IoT-Internship-CarAutomation-LUS/Car-Automation/hardware/README.md

# Hardware / Procurement

**Owner: Venkat**

Platform build, parts research, wiring diagrams, and build photos.

- `wiring/` — connection diagrams and pin maps.
- `photos/` — build progress photos.
- Parts list lives in `../docs/parts-list.md`.

Phase 1 = cheap servo proof-of-concept car with the two-node CAN bus. **No buying until budget sign-off.**
