IoT-Internship-CarAutomation-LUS/Car-Automation/docs/day-reports/README.md

# Daily Reports

Day-by-day planning and progress documents (Word/PDF versions are shared with the team lead; key ones summarised here).

- Day 1 — Board 1 hardware documentation
- Day 2 — Board 2 GPS + CAN bring-up (GPS working, CAN loopback passing)
- Day 3 — ELM327 + TPMS research, 32/16-byte payload design
- Day 4 — System design & integration plan (two dashboards, architecture, tracks)
- Day 5 — Cloud streaming + in-house ELM327 direction (in progress)
