IoT-Internship-CarAutomation-LUS/Car-Automation/docs/day-reports/2026-07-31.md

# Day Report — 2026-07-31

This file has two parts. The **Automated Activity Log** is generated from git — it never needs to be typed by hand, and re-running the digest just refreshes it without touching anything below. The **Team Notes** and **Day Summary** are manual — git can't know what worked, what didn't, or what the output looked like. That part only a person can write.

## Automated Activity Log
<!-- AUTO:START -->
**5 commit(s) on 2026-07-31**

### `(root)/`
- `17:09` **ShahidMihransha** — docs: refresh README for real-vehicle-only track and schema v2.0.0 (`1bfdc2c`)
- `20:54` **ShaahirAhamed** — added (`ccc50ee`)

### `Internship/`
- `17:09` **ShahidMihransha** — Add Accelerator Actuation, Data Collection, and Final Internship Report docs (`63e585f`)

### `backend/`
- `17:09` **ShahidMihransha** — Add Accelerator Actuation, Data Collection, and Final Internship Report docs (`63e585f`)
- `17:09` **ShahidMihransha** — Simplify elm327_bt.py TCP forwarding and drop redundant gear estimation (`f857870`)
- `17:09` **ShahidMihransha** — docs: refresh README for real-vehicle-only track and schema v2.0.0 (`1bfdc2c`)
- `20:42` **ShaahirAhamed** — changed something small (`4f6ab03`)
- `20:54` **ShaahirAhamed** — added (`ccc50ee`)

<!-- AUTO:END -->

## Team Notes (fill in manually)

Everyone who did meaningful work today adds a short block below. Copy the template for each person/track. Keep it brief — a few lines each is enough.

### [Name — Track]
- **What was done:**
- **What worked:**
- **What didn't work / issues:**
- **Output / result:**
- **Next steps:**

<!-- copy the block above for each additional person -->

## Day Summary (team lead)

- **Overall progress:**
- **Blockers:**
- **Decisions made today:**
