IoT-Internship-CarAutomation-LUS/Car-Automation/docs/day-reports/2026-07-18.md

# Day Report — 2026-07-18

This file has two parts. The **Automated Activity Log** is generated from git — it never needs to be typed by hand, and re-running the digest just refreshes it without touching anything below. The **Team Notes** and **Day Summary** are manual — git can't know what worked, what didn't, or what the output looked like. That part only a person can write.

## Automated Activity Log
<!-- AUTO:START -->
**8 commit(s) on 2026-07-18**

### `(root)/`
- `01:10` **ShahidMihransha** — Add tracked pre-commit hook to block unresolved merge conflict markers (`40b3c95`)

### `Internship/`
- `14:51` **ShaahirAhamed** — changed the folder of the Day4 Document (`381ea79`)

### `backend/`
- `01:32` **ShahidMihransha** — Resolve unresolved merge conflict markers from 89e4c6b (`ce5e733`)
- `01:39` **ShahidMihransha** — Add --tcp mode for direct Pi-to-laptop packet streaming (`2351c3f`)
- `02:14` **ShahidMihransha** — Add raw_receiver.py and decoded_receiver.py for --tcp bench-test link (`2eeee9b`)

### `dashboard-telemetry/`
- `15:15` **ShaahirAhamed** — modifified the front end code to work with the updated backend (`075eef4`)

### `firmware/`
- `19:15` **ShaahirAhamed** — Added a new sketch for Reverse Engineering CAN using esp32 (`5ad7f15`)

### `scripts/`
- `01:10` **ShahidMihransha** — Add tracked pre-commit hook to block unresolved merge conflict markers (`40b3c95`)
- `17:17` **ShaahirAhamed** — Added a Can_sniffer to reverse engineer manufacure raw hex (`67a1dd0`)

<!-- AUTO:END -->

## Team Notes (fill in manually)

Everyone who did meaningful work today adds a short block below. Copy the template for each person/track. Keep it brief — a few lines each is enough.

### [Name — Track]
- **What was done:**
- **What worked:**
- **What didn't work / issues:**
- **Output / result:**
- **Next steps:**

<!-- copy the block above for each additional person -->

## Day Summary (team lead)

- **Overall progress:**
- **Blockers:**
- **Decisions made today:**
