IoT-Internship-CarAutomation-LUS/Car-Automation/docs/day-reports/2026-07-15.md

# Day Report — 2026-07-15

This file has two parts. The **Automated Activity Log** is generated from git — it never needs to be typed by hand, and re-running the digest just refreshes it without touching anything below. The **Team Notes** and **Day Summary** are manual — git can't know what worked, what didn't, or what the output looked like. That part only a person can write.

## Automated Activity Log
<!-- AUTO:START -->
**3 commit(s) on 2026-07-15**

### `(root)/`
- `08:44` **ShaahirAhamed** — added a logs folder for dumping backend and frontend logs (`5d9c6c3`)
- `13:50` **ShahidMihransha** — cleanup (`b2992a4`)

### `Internship/`
- `13:54` **ShahidMihransha** — docs: add Three Day Progress Report (docx + pdf) (`7ad4e63`)

### `backend/`
- `13:50` **ShahidMihransha** — cleanup (`b2992a4`)

### `dashboard-control/`
- `13:50` **ShahidMihransha** — cleanup (`b2992a4`)

### `dashboard-telemetry/`
- `13:50` **ShahidMihransha** — cleanup (`b2992a4`)

### `docs/`
- `13:50` **ShahidMihransha** — cleanup (`b2992a4`)

<!-- AUTO:END -->

## Team Notes (fill in manually)

Everyone who did meaningful work today adds a short block below. Copy the template for each person/track. Keep it brief — a few lines each is enough.

### [Name — Track]
- **What was done:**
- **What worked:**
- **What didn't work / issues:**
- **Output / result:**
- **Next steps:**

<!-- copy the block above for each additional person -->

## Day Summary (team lead)

- **Overall progress:**
- **Blockers:**
- **Decisions made today:**
