IoT-Internship-CarAutomation-LUS/Car-Automation/docs/day-reports/2026-07-14.md

# Day Report — 2026-07-14

This file has two parts. The **Automated Activity Log** is generated from git — it never needs to be typed by hand, and re-running the digest just refreshes it without touching anything below. The **Team Notes** and **Day Summary** are manual — git can't know what worked, what didn't, or what the output looked like. That part only a person can write.

## Automated Activity Log
<!-- AUTO:START -->
**3 commit(s) on 2026-07-14**

### `(root)/`
- `16:43` **ShahidMihransha** — Land OBD/ELM327 acquisition pipeline + schema versioning (`78e28c0`)

### `Instruction Docs/`
- `16:43` **ShahidMihransha** — Land OBD/ELM327 acquisition pipeline + schema versioning (`78e28c0`)

### `Internship/`
- `16:43` **ShahidMihransha** — Land OBD/ELM327 acquisition pipeline + schema versioning (`78e28c0`)
- `16:57` **ShahidMihransha** — docs (`d92741a`)

### `backend/`
- `16:43` **ShahidMihransha** — Land OBD/ELM327 acquisition pipeline + schema versioning (`78e28c0`)

### `dashboard-telemetry/`
- `16:43` **ShahidMihransha** — Land OBD/ELM327 acquisition pipeline + schema versioning (`78e28c0`)

### `docs/`
- `16:43` **ShahidMihransha** — Land OBD/ELM327 acquisition pipeline + schema versioning (`78e28c0`)
- `16:45` **daily-digest-bot** — docs: update daily activity digest [automated] (`7826f3b`)

### Pull requests merged
- #7 Land Schema_Versioning: OBD/ELM327 pipeline + schema versioning (history-scrubbed) — @ShahidMihransha

<!-- AUTO:END -->

## Team Notes (fill in manually)

Everyone who did meaningful work today adds a short block below. Copy the template for each person/track. Keep it brief — a few lines each is enough.

### [Name — Track]
- **What was done:**
- **What worked:**
- **What didn't work / issues:**
- **Output / result:**
- **Next steps:**

<!-- copy the block above for each additional person -->

## Day Summary (team lead)

- **Overall progress:**
- **Blockers:**
- **Decisions made today:**
