IoT-Internship-CarAutomation-LUS/Car-Automation/docs/day-reports/2026-07-06.md

# Day Report — 2026-07-06

## Automated Activity Log
<!-- AUTO:START -->
**11 commit(s) on 2026-07-06**

### `(root)/`
- `13:15` **Shaahir** — changed mock_telemetry.py (`1f4dce7`)
- `14:12` **ShahidMihransha** — docs: reconcile URLs, backend status, and schema drift; consolidate specs into docs/ (`4a465f7`)
- `15:54` **Shaahir** — Fixed an error in deployment that caused the css file to not load properly. (`ced2e95`)
- `16:00` **Shaahir** — deleted a unnecessary file, timetable.html (`4a7146b`)
- `16:02` **Shaahir** —  Modified .gitignore to include timetable.html,  ensuring it is ignored by Git. (`0fc4095`)
- `16:29` **ShahidMihransha** — chore: repo hygiene - gitignore, untrack db files, remove stray file, scrub name (`cc6f6b1`)
- `16:32` **ShahidMihransha** — docs: rescue ONBOARDING.md, day-report template, and Day5 docs from stale branch (`938bf81`)

### `Internship/`
- `16:32` **ShahidMihransha** — docs: rescue ONBOARDING.md, day-report template, and Day5 docs from stale branch (`938bf81`)

### `backend/`
- `13:15` **Shaahir** — changed mock_telemetry.py (`1f4dce7`)
- `14:12` **ShahidMihransha** — docs: reconcile URLs, backend status, and schema drift; consolidate specs into docs/ (`4a465f7`)

### `dashboard-control/`
- `14:12` **ShahidMihransha** — docs: reconcile URLs, backend status, and schema drift; consolidate specs into docs/ (`4a465f7`)
- `15:54` **Shaahir** — Fixed an error in deployment that caused the css file to not load properly. (`ced2e95`)

### `dashboard-telemetry/`
- `11:34` **Sapthagiri** — added changed Team leader assigned (`0ed2533`)
- `14:12` **ShahidMihransha** — docs: reconcile URLs, backend status, and schema drift; consolidate specs into docs/ (`4a465f7`)
- `14:58` **Sapthagiri** — made a change to display brake percentage (`a0e8eaa`)
- `15:54` **Shaahir** — Fixed an error in deployment that caused the css file to not load properly. (`ced2e95`)

### `docs/`
- `14:12` **ShahidMihransha** — docs: reconcile URLs, backend status, and schema drift; consolidate specs into docs/ (`4a465f7`)
- `14:51` **daily-digest-bot** — docs: update daily activity digest [automated] (`9a70024`)
- `15:27` **ShahidMihransha** — docs: mark backend brief as built/deployed and parts-list Phase 1 as superseded (`a019238`)
- `16:32` **ShahidMihransha** — docs: rescue ONBOARDING.md, day-report template, and Day5 docs from stale branch (`938bf81`)

### Pull requests merged
- #5 docs: reconcile URLs, backend status, schema drift; consolidate specs into docs/ — @ShahidMihransha

<!-- AUTO:END -->

## Team Notes (fill in manually)

## Day Summary
