IoT-Internship-CarAutomation-LUS/Car-Automation/docs/day-reports/2026-07-03.md

# Day Report — 2026-07-03

## Automated Activity Log
<!-- AUTO:START -->
**7 commit(s) on 2026-07-03**

### `(root)/`
- `15:55` **ShahidMihransha** — Initial repo structure, docs, dashboards, firmware (`e30d138`)

### `.github/`
- `17:06` **ShahidMihransha** — fix: daily digest committer-date bug, error handling, backfill input (`f44ce5b`)
- `17:44` **ShahidMihransha** — fix: use committer date for digest grouping, add error handling, PAT-based push, and backfill dispatch input (`10b50ef`)

### `Internship/`
- `15:55` **ShahidMihransha** — Initial repo structure, docs, dashboards, firmware (`e30d138`)

### `backend/`
- `15:55` **ShahidMihransha** — Initial repo structure, docs, dashboards, firmware (`e30d138`)

### `dashboard-control/`
- `15:55` **ShahidMihransha** — Initial repo structure, docs, dashboards, firmware (`e30d138`)
- `16:44` **Shaahir** — Sathish Added History (`9bed36a`)

### `dashboard-telemetry/`
- `15:55` **ShahidMihransha** — Initial repo structure, docs, dashboards, firmware (`e30d138`)
- `16:27` **Shaahir** — added the history page (`f8c136e`)

### `docs/`
- `15:55` **ShahidMihransha** — Initial repo structure, docs, dashboards, firmware (`e30d138`)
- `17:49` **daily-digest-bot** — docs: update daily activity digest [automated] (`cb21a8a`)
- `17:50` **daily-digest-bot** — docs: update daily activity digest [automated] (`3b6238b`)

### `firmware/`
- `15:55` **ShahidMihransha** — Initial repo structure, docs, dashboards, firmware (`e30d138`)

### `hardware/`
- `15:55` **ShahidMihransha** — Initial repo structure, docs, dashboards, firmware (`e30d138`)

### `scripts/`
- `17:06` **ShahidMihransha** — fix: daily digest committer-date bug, error handling, backfill input (`f44ce5b`)
- `17:44` **ShahidMihransha** — fix: use committer date for digest grouping, add error handling, PAT-based push, and backfill dispatch input (`10b50ef`)

### `sensing/`
- `15:55` **ShahidMihransha** — Initial repo structure, docs, dashboards, firmware (`e30d138`)

### Pull requests merged
- #2 fix: use committer date for digest grouping, add error handling, PAT-… — @ShahidMihransha
- #1 fix: daily digest committer-date bug, error handling, backfill input — @ShahidMihransha

<!-- AUTO:END -->

## Team Notes (fill in manually)

## Day Summary
