IoT-Internship-CarAutomation-LUS/Car-Automation/docs/day-reports/2026-07-04.md

# Day Report — 2026-07-04

## Automated Activity Log
<!-- AUTO:START -->
No commits recorded for this date.

<!-- AUTO:END -->

## Team Notes (fill in manually)

## Day Summary
