IoT-Internship-CarAutomation-LUS/Car-Automation/Internship/PDF/IoT_Internship_Board2_GPS_CAN_Bringup_Report (1).pdf

# ESP32 Vehicle Tracking System

## Board 2 Bring-up - Daily Work Report

IoT Development Team - Car Automation Internship

## 1. Aim of Today's Work

The aim of today's session was to bring up the second ESP32 prototype board and test two of its main modules individually: the GPS module (for live location) and the MCP2515 CAN module (for reading vehicle parameters). The goal was to prove that each module is correctly wired and working before combining everything into the final telemetry system.

Board 2 contains three modules in total: the NEO-6M GPS, the SIM800L GSM module, and the MCP2515 CAN controller. Today we successfully tested the GPS and the CAN module. The SIM800L was started but is left for the next session.

## 2. Components Used

- ESP32 development board
- GY-GPS6MV2 module (u-blox NEO-6M) with ceramic patch antenna
- MCP2515 CAN module (with TJA1050 transceiver, 8 MHz crystal)
- SIM800L EVB module (started but not completed today)
- Jumper wires and USB data cable
- Arduino IDE with TinyGPSPlus and mcp_can (coryjfowler) libraries

## 3. Wiring / Connection Details

### 3.1 GPS Module (NEO-6M) to ESP32

The GPS communicates with the ESP32 using a serial (UART) connection. The TX and RX lines are crossed (GPS TX goes to ESP32 RX, and GPS RX goes to ESP32 TX).

GPS Pin | ESP32 Pin | Purpose
VCC | 3V3 | Power (3.3V)
GND | GND | Ground
TX | D5 | GPS sends data to ESP32
RX | D4 | ESP32 sends data to GPS

### 3.2 MCP2515 CAN Module to ESP32

The CAN module communicates using the SPI bus. We used the ESP32's default VSPI pins for SCK, MISO and MOSI, plus a chip-select (CS) pin and an interrupt (INT) pin.

CAN Pin | ESP32 Pin | Purpose
VCC | 5V / VIN | Power (5V)
GND | GND | Ground
SCK | D18 | SPI clock
SO (MISO) | D19 | Data from CAN to ESP32
SI (MOSI) | D23 | Data from ESP32 to CAN
CS | D32 | Chip select
INT | D33 | Interrupt (new message ready)

### 3.3 Power Summary

Connection | Supply
GPS VCC | 3.3V
CAN VCC | 5V / VIN
All GND | Common ground

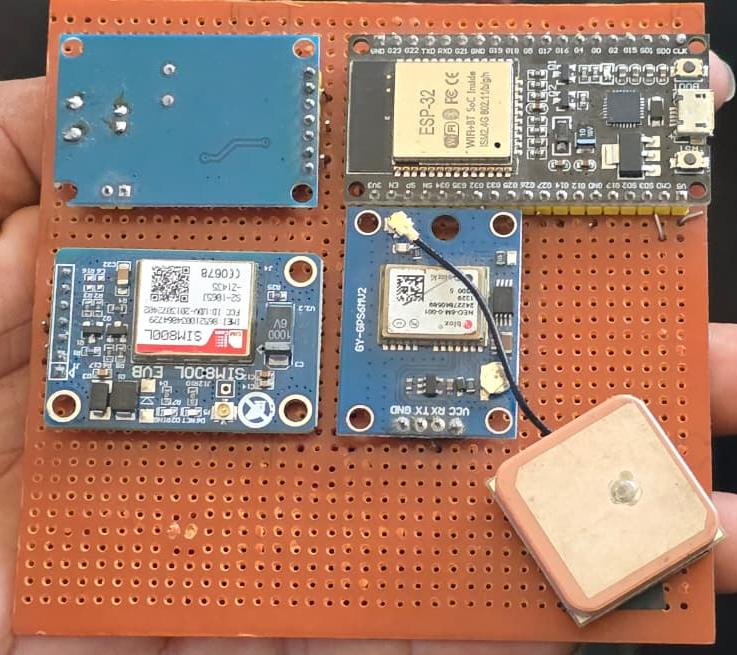
[picture p40: figure]
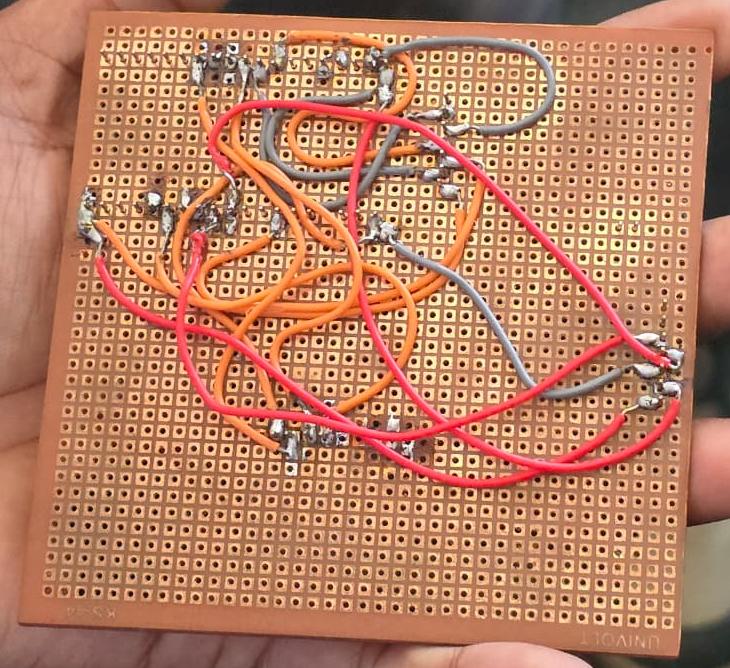
[picture p41: figure]

## 4. Work Done

A single Arduino test program was written to start all three modules together. The GPS is read on UART1, the SIM800L on UART2, and the CAN module on the SPI bus. The program prints a status line every 2 seconds so we can see what each module is doing on the Serial Monitor (baud 115200).

The two modules were tested one at a time:

1. First the GPS was taken to an open area to get a position fix.
2. Then the CAN module was tested using a loopback self-test (no vehicle needed).

## 5. Outputs Obtained

### 5.1 GPS Output (Live Location)

After being given a clear view of the sky, the GPS locked on to satellites and gave a valid position fix. A sample output line from the Serial Monitor:

[GPS] FIX lat 12.920364 lng 80.131663 sats 7 alt 19.9m spd 1.2 km/h 10:54:17 UTC
The position (12.9203 N, 80.1316 E) matched our actual location in Chennai. The number of satellites used reached 6-7, and the accuracy value (HDOP) came down to about 1.7-1.8, which is a good and reliable fix.

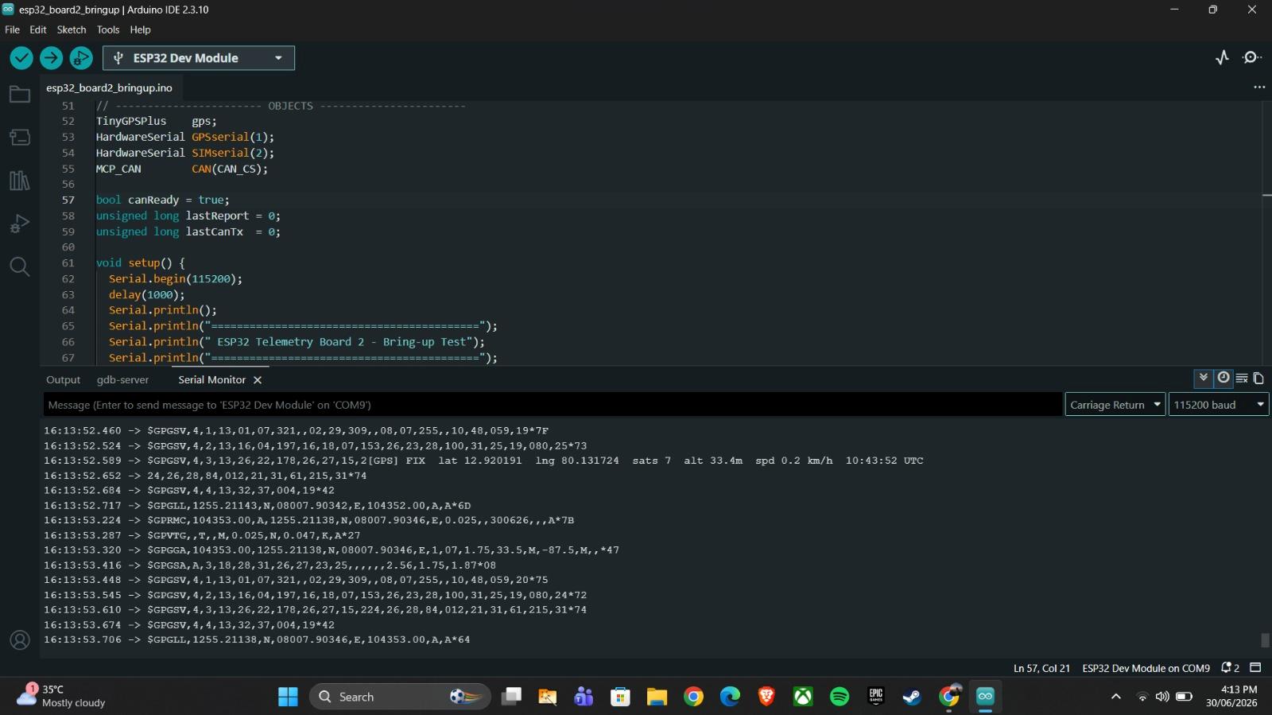
[picture p42: figure]

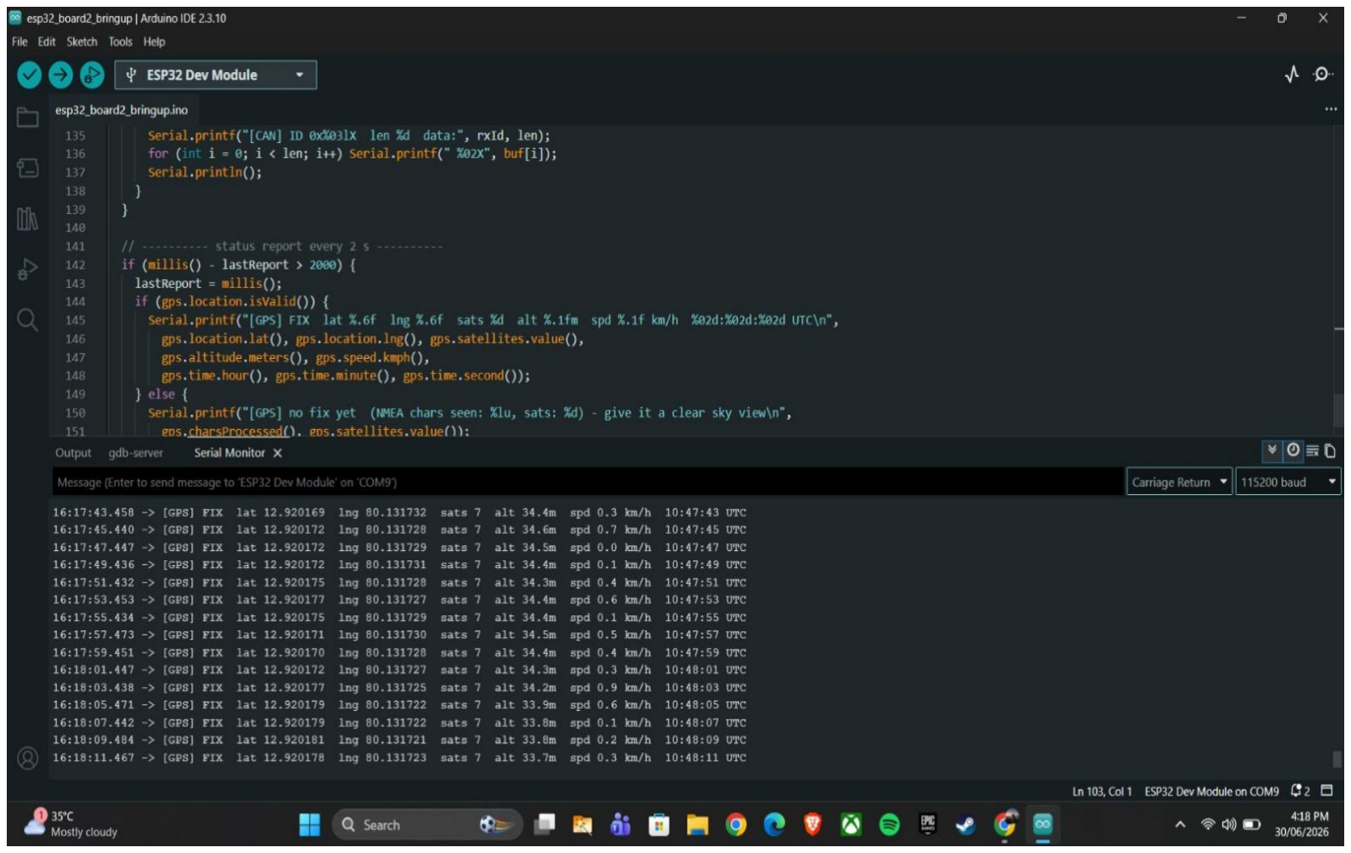
[picture p43: figure]

### 5.2 CAN Output (Loopback Self-Test)

The CAN module was tested in loopback mode. In this mode the MCP2515 sends a test message and then receives its own message back. This proves the chip and the SPI wiring work without needing a real car. Sample output:

[CAN] loopback test frame sent (0x123)
[CAN] ID 0x123 len 8 data: DE AD BE EF 01 02 03 04
The message that was sent (DE AD BE EF 01 02 03 04) came back correctly, which means the SPI wiring, the CS pin, the INT pin and the MCP2515 chip are all working. The GPS and CAN outputs were also seen running together at the same time without any problem.

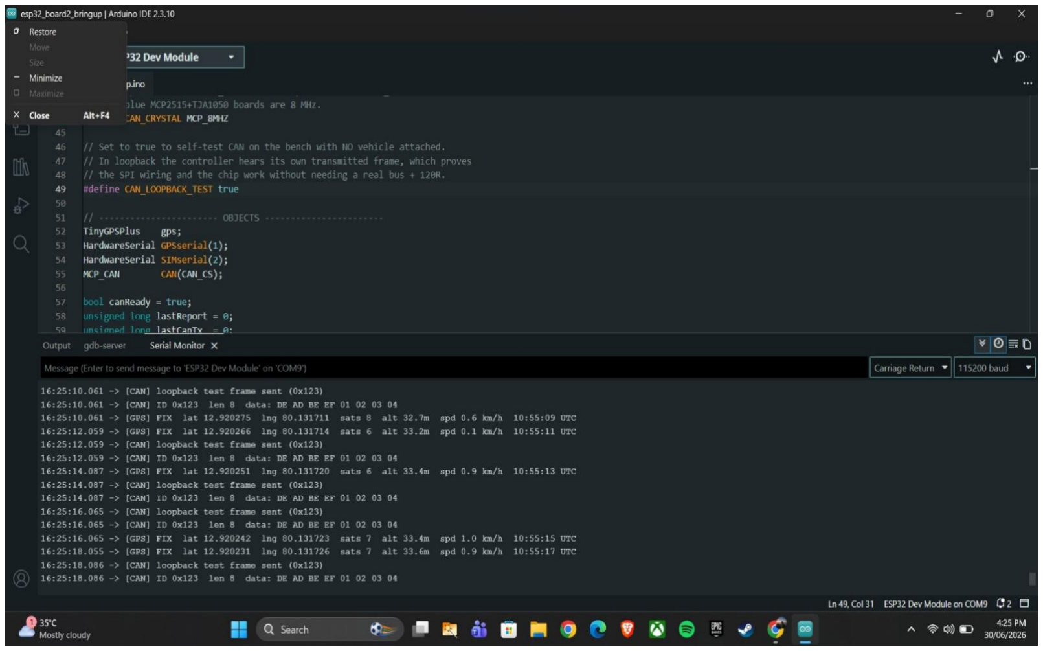
[picture p44: figure]

## 6. Issues Faced and How We Solved Them

Issue 1: GPS was not giving any fix for a long time (sats: 0).
Solution: The GPS was indoors and could not see enough satellites. A position fix needs at least 4 satellites at the same time, and a first-time (cold) start can take around 12 minutes. We took the antenna to an open sky area, kept it flat and face-up, and did not reset the board. It then locked on.

Issue 2: The board kept resetting, which restarted the GPS search each time. Solution: Every reset makes the GPS start its satellite download from the beginning. We stopped touching/resetting the board and let it run continuously, after which it got the fix.

Issue 3: The Serial Monitor was full of raw GPS text and we could not read the other module replies.
Solution: An extra debug line (Serial.write) was printing every raw GPS sentence. We removed that line so the program only prints the clean status messages.

Issue 4: CAN module printed nothing on the bench.
Solution: On the bench there is no real vehicle bus, so in normal mode the CAN module has nothing to receive. We switched ON the loopback self-test (CAN_LOOPBACK_TEST = true), which makes the module talk to itself, and the frames appeared.

Issue 5: SIM800L did not reply 'OK' to the AT command.
Solution: The module stayed silent. This is left for the next session - we will re-check its power supply (it needs a strong 5V), the power/PWR button on the module, the line-ending setting (Both NL & CR), and that the TX/RX wires are crossed correctly.

## 7. Result / Conclusion

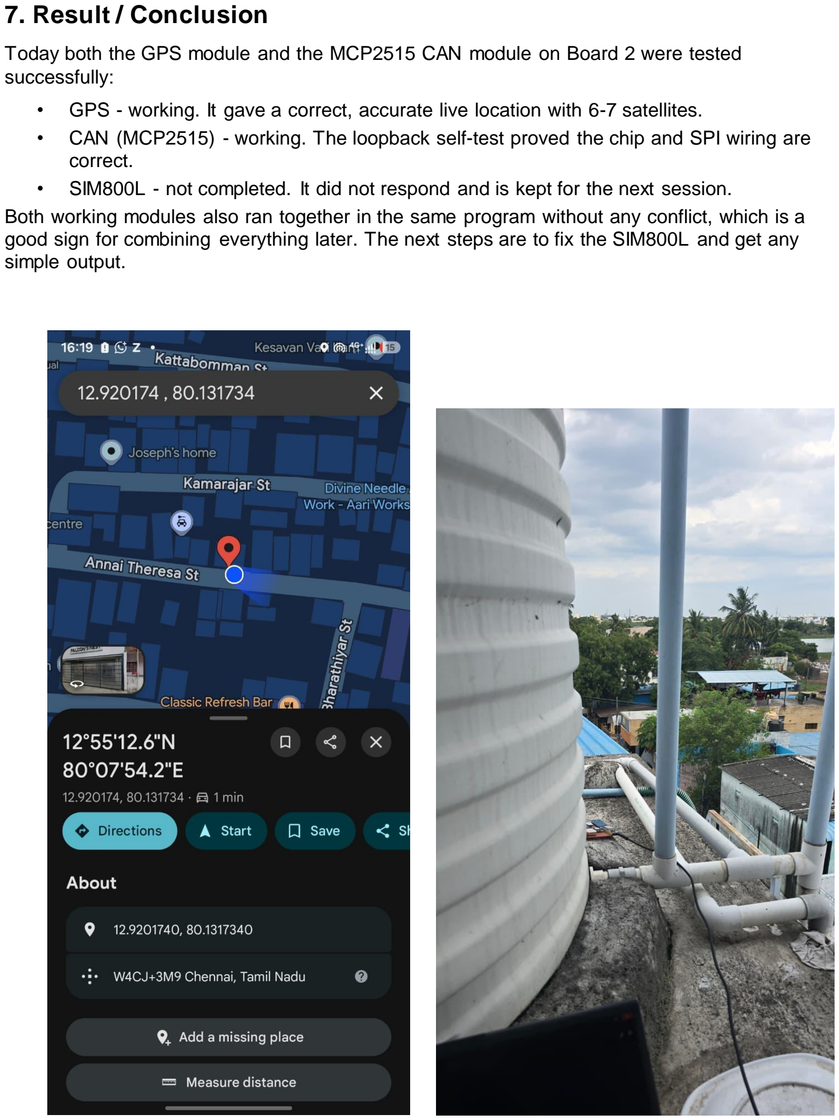
[picture p45: page 6]

Today both the GPS module and the MCP2515 CAN module on Board 2 were tested successfully:

- GPS - working. It gave a correct, accurate live location with 6-7 satellites.
- CAN (MCP2515) - working. The loopback self-test proved the chip and SPI wiring are correct.
- SIM800L - not completed. It did not respond and is kept for the next session.
Both working modules also ran together in the same program without any conflict, which is a good sign for combining everything later. The next steps are to fix the SIM800L and get any simple output.
