IoT-Internship-CarAutomation-LUS/Car-Automation/(commit log)

2026-07-03 Fixed Sathish's shit and alos pushed my backend
    [config.py, database.py, main.py, routes.py, websocket_handler.py]
2026-07-03 fix: use committer date for digest grouping, add error handling, PAT-based push, and backfill dispatch input
    - generate_daily_digest.py: bucket commits by committer date (%cd) instead
    of author date (%ad) so rebase-merged commits land in the day they
    actually merged, not the day they were originally authored.
    - generate_daily_digest.py: git log failures now raise RuntimeError instead
    of being silently swallowed as "0 commits".
    - daily-digest.yml: checkout now uses a DIGEST_PUSH_TOKEN PAT so the push
    is attributed to a repo admin, satisfying the ruleset's role-based bypass
    (the default GITHUB_TOKEN identity isn't coverable by that bypass list).
    - daily-digest.yml: workflow_dispatch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
2026-07-06 docs: reconcile URLs, backend status, and schema drift; consolidate specs into docs/
    - URLs: backend is api.nalusa.space (wss://api.nalusa.space/ws), distinct
    from Dashboard 1 (lus.nalusa.space) and Dashboard 2 (dashboard2.nalusa.space).
    Fixes docs/MESSAGE_SCHEMA.md §5 and docs/BACKEND_BRIEF.md, which both
    incorrectly assumed the backend would share Dashboard 1's domain.
    - Backend status: rewrite backend/README.md and root README's status
    board/objectives table to reflect that the backend is built and deployed
    (FastAPI + SQLite, 6 REST endpoints, 3 mock senders), not "planning."
    Company-cloud migration is now noted as an open future item.
    - Consolidate MESSAGE_SCHEMA.md/BACKEND_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
2026-07-06 made a change to display brake percentage
2026-07-06 docs: mark backend brief as built/deployed and parts-list Phase 1 as superseded
    Backend is live at api.nalusa.space; parts-list reflects the pre-reframe
    Phase 1 servo build, now kept only as historical record for Track 2.
2026-07-14 Land OBD/ELM327 acquisition pipeline + schema versioning
    Squash-landing of the Schema_Versioning branch (via a history-scrubbed
    copy, schema-versioning-clean) onto main. main and Schema_Versioning
    share no common git ancestor after main's own history rewrite, so this
    replays the net changes as a single commit rather than attaching
    parallel history.
    - New OBD/ELM327 acquisition pipeline: backend/elm327_bt.py,
    backend/obd_decoder.py, backend/mock_obd.py, backend/requirements.txt.
    - Schema versioning formalized across backend/config.py,
    backend/mock_rc_platform.py, backend/mock_telemetry.py,
    backend/websocket_handler.py, dashboard-telemetry/a.js, and
    docs/MESSAGE_SCHEMA.md (also formal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
2026-07-16 added a new gear algorithm to find approximately calculate the gear state
2026-07-17 Add tracked pre-commit hook to block unresolved merge conflict markers
    A merge (89e4c6b) committed <<<<<<< HEAD / ======= / >>>>>>> markers
    straight into main across obd_decoder.py, elm327_bt.py, and config.py,
    breaking all three (SyntaxError, nothing importable) until now. A hook
    in .git/hooks wouldn't have stopped that -- it lives per-clone and the
    break came from a different machine. This one is tracked in the repo
    under scripts/hooks/ and documented in CONTRIBUTING.md so every
    teammate wires it in with one `git config core.hooksPath` command.
2026-07-17 Resolve unresolved merge conflict markers from 89e4c6b
    89e4c6b landed <<<<<<< HEAD / ======= / >>>>>>> markers straight onto
    main in backend/config.py, backend/elm327_bt.py, and backend/obd_decoder.py,
    breaking all three (SyntaxError on import).
    Resolves by taking b2992a4 as the base and merging in calculate_gear.
    Gear now flows through extras at byte 18 instead of being recomputed
    in unpack_packet.
    [config.py, elm327_bt.py, obd_decoder.py]
2026-07-18 Added a new sketch for Reverse Engineering CAN using esp32
2026-07-31 docs: refresh README for real-vehicle-only track and schema v2.0.0
    The self-built platform track and Control Console were cancelled 15 Jul;
    ELM327 OBD data and real-car sensing are now proven on the vehicle via
    the Raspberry Pi, not pending. Updates status board, objectives, and
    architecture diagram to match, and credits CAN sniffing to Shahid/Shaahir.
2026-07-31 Simplify elm327_bt.py TCP forwarding and drop redundant gear estimation
    Gear is already estimated server-side in websocket_handler.py, so
    computing it again on the Pi just risked the two disagreeing.
